alptekin254802/hall-sensor/THIRD_PARTY_NOTICES.md

# Third-party components

The MIT license at the repository root applies to original project code. It
does not replace copyright or license notices in STM32-generated sources,
CMSIS, or the STM32 HAL drivers. Both STM32 source snapshots preserve the
vendor source headers and the supplied license files under their `Drivers/`
directories, including CMSIS and ST device and HAL licenses.

Python, NumPy, pyserial, GNU Arm Embedded tools and Arduino tools are external
dependencies and are not redistributed here. The Creative Commons license
text is reproduced from https://creativecommons.org/licenses/by/4.0/legalcode.txt.
