alptekin254802/hall-sensor/figures/Figure_2_hardware_architecture.pdf

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

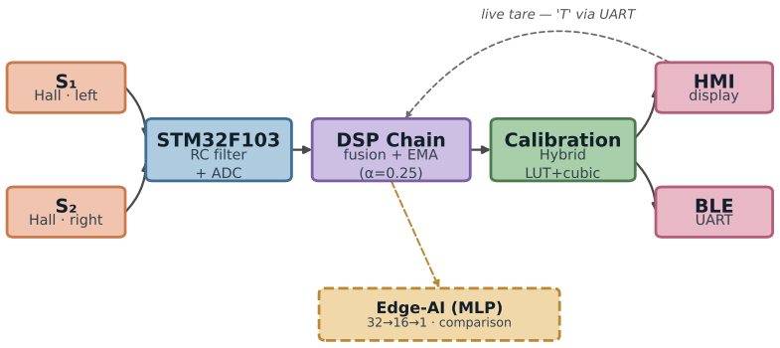
[picture p3: figure]
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
