alptekin254802/hall-sensor/figures/Figure_1a_pcb_final_implementation.jpg

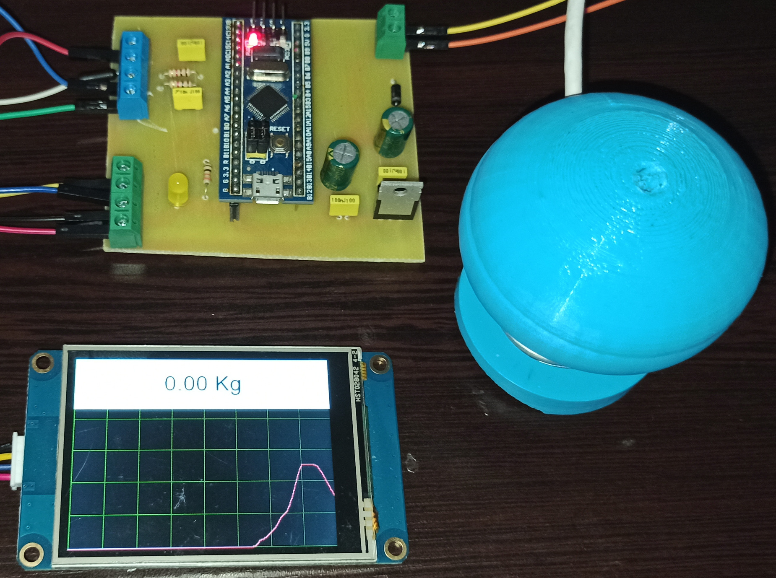
figures/Figure_1a_pcb_final_implementation.jpg
