alptekin254802/hall-sensor/figures/Figure_1b_physical_prototype_views.jpg

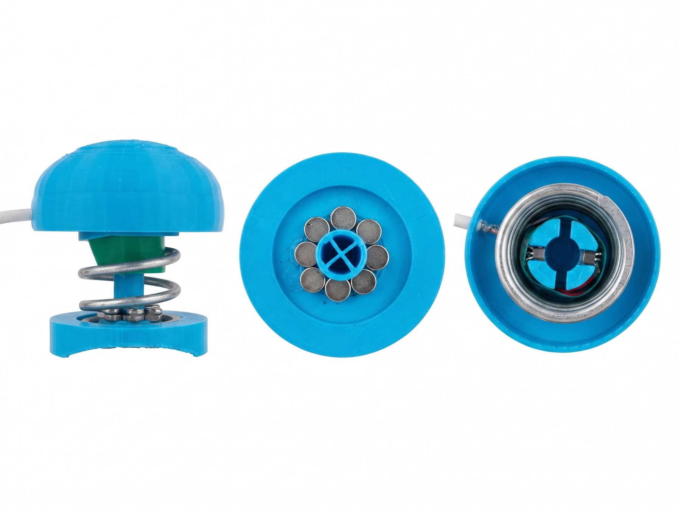
figures/Figure_1b_physical_prototype_views.jpg
