alptekin254802/hall-sensor/data/calibration_plateau_samples.csv

idx | block_grams | block_kg | sample_in_block | S1 | S2 | ORT
0 | 0 | 0.0 | 0 | 2583 | 2671 | 0
1 | 0 | 0.0 | 1 | 2576 | 2671 | 3
2 | 0 | 0.0 | 2 | 2585 | 2670 | 1
3 | 0 | 0.0 | 3 | 2577 | 2669 | 3
4 | 0 | 0.0 | 4 | 2577 | 2670 | 3
5 | 0 | 0.0 | 5 | 2576 | 2671 | 3
6 | 0 | 0.0 | 6 | 2581 | 2670 | 1
7 | 0 | 0.0 | 7 | 2588 | 2672 | 3
8 | 0 | 0.0 | 8 | 2581 | 2668 | 2
9 | 0 | 0.0 | 9 | 2580 | 2662 | 5
10 | 0 | 0.0 | 10 | 2580 | 2666 | 3
11 | 0 | 0.0 | 11 | 2578 | 2671 | 2
12 | 0 | 0.0 | 12 | 2575 | 2670 | 4
13 | 0 | 0.0 | 13 | 2579 | 2672 | 1
14 | 0 | 0.0 | 14 | 2582 | 2670 | 0
15 | 0 | 0.0 | 15 | 2578 | 2669 | 3
16 | 0 | 0.0 | 16 | 2580 | 2668 | 2
17 | 0 | 0.0 | 17 | 2578 | 2671 | 2
18 | 0 | 0.0 | 18 | 2576 | 2667 | 5
19 | 0 | 0.0 | 19 | 2580 | 2670 | 1
20 | 0 | 0.0 | 20 | 2571 | 2667 | 7
21 | 0 | 0.0 | 21 | 2578 | 2672 | 1
22 | 0 | 0.0 | 22 | 2584 | 2667 | 1
23 | 0 | 0.0 | 23 | 2580 | 2669 | 2
24 | 0 | 0.0 | 24 | 2576 | 2669 | 4
25 | 0 | 0.0 | 25 | 2578 | 2672 | 1
26 | 0 | 0.0 | 26 | 2579 | 2670 | 2
27 | 0 | 0.0 | 27 | 2581 | 2671 | 0
28 | 0 | 0.0 | 28 | 2571 | 2672 | 5
29 | 0 | 0.0 | 29 | 2577 | 2674 | 1
30 | 0 | 0.0 | 30 | 2577 | 2670 | 3
31 | 0 | 0.0 | 31 | 2580 | 2669 | 2
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
