alptekin254802/hall-sensor/figures/Figure_11_mlp_training_history.pdf

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

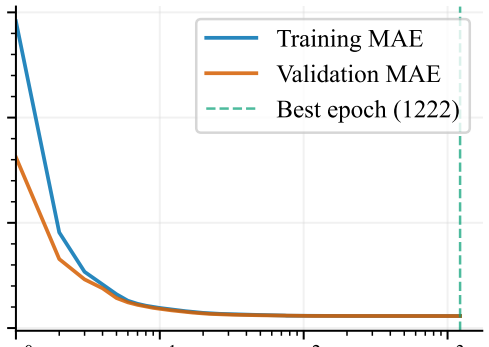
[picture p7: figure]
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
