alptekin254802/hall-sensor/figures/Figure_5_dynamic_response.pdf

## Experimental plateaus

### Dynamic Step Response and Return-to-Zero Stability at Multiple Mass Loads

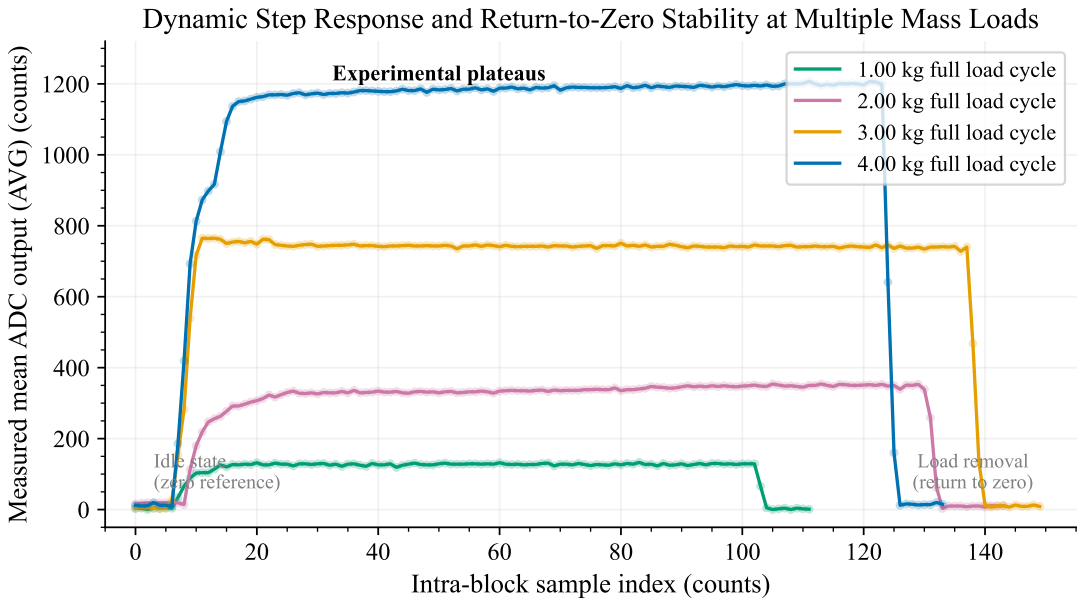
[picture p8: page 1]
Idle state (zero reference)

Measured mean ADC output (AVG) (counts)

1.00 kg full load cycle
2.00 kg full load cycle
3.00 kg full load cycle
4.00 kg full load cycle

Load removal
(return to zero)

Intra-block sample index (counts)
