alptekin254802/hall-sensor/figures/Figure_12_model_comparison_calibration_curve.pdf

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

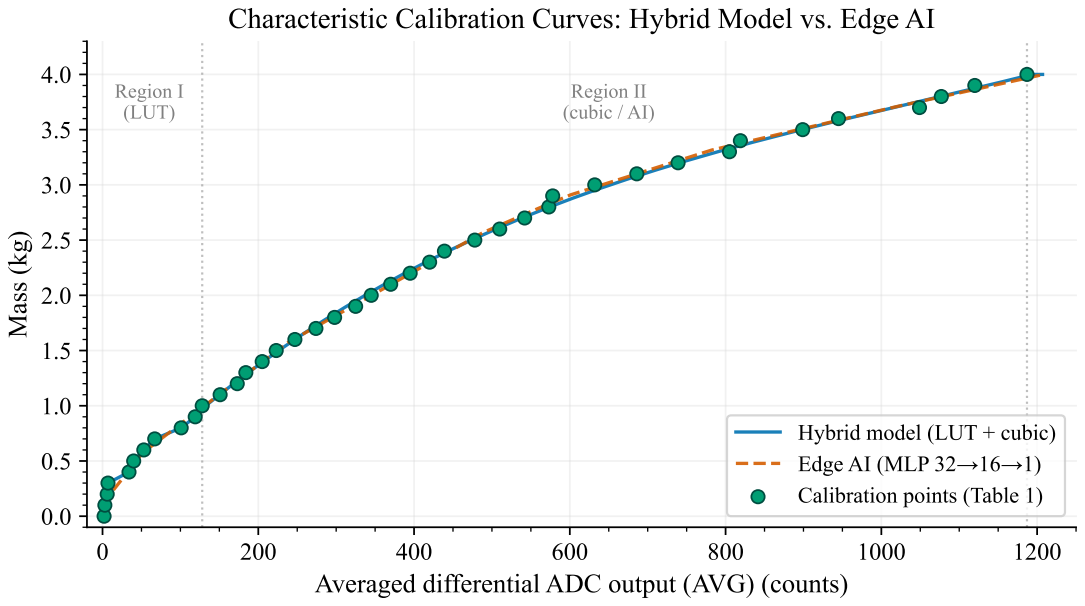
[picture p9: page 1]
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
