alptekin254802/hall-sensor/figures/Figure_6_calibration_residual_error.pdf

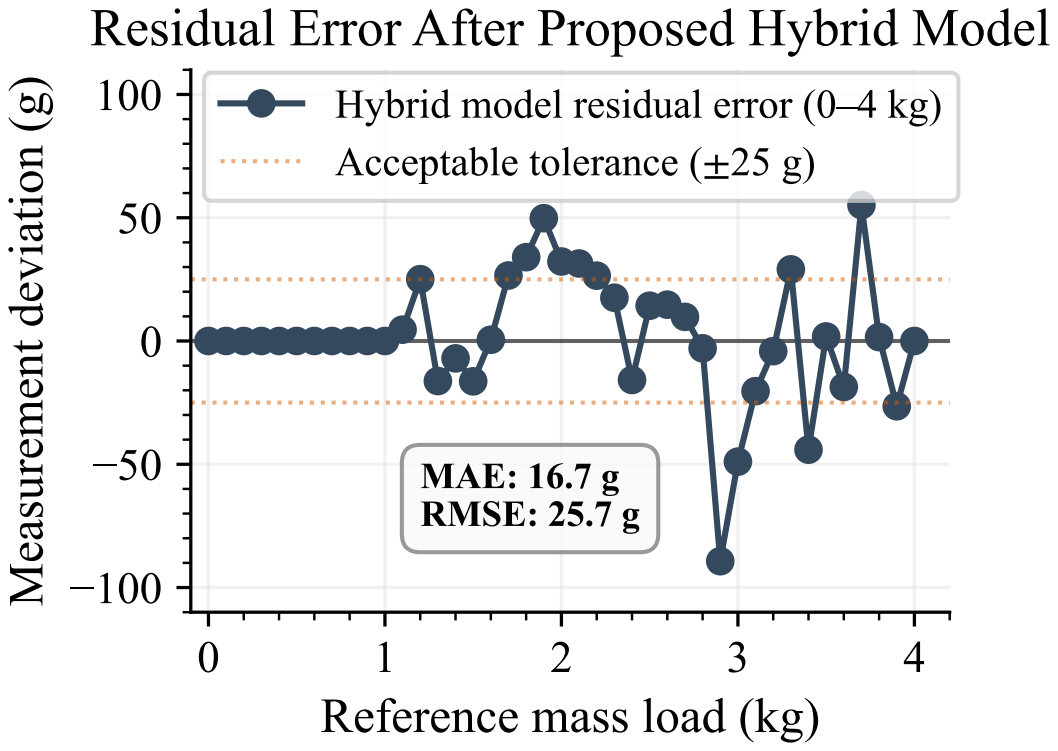
[picture p10: page 1]
