alptekin254802/hall-sensor/figures/Figure_9_live_validation_error.pdf

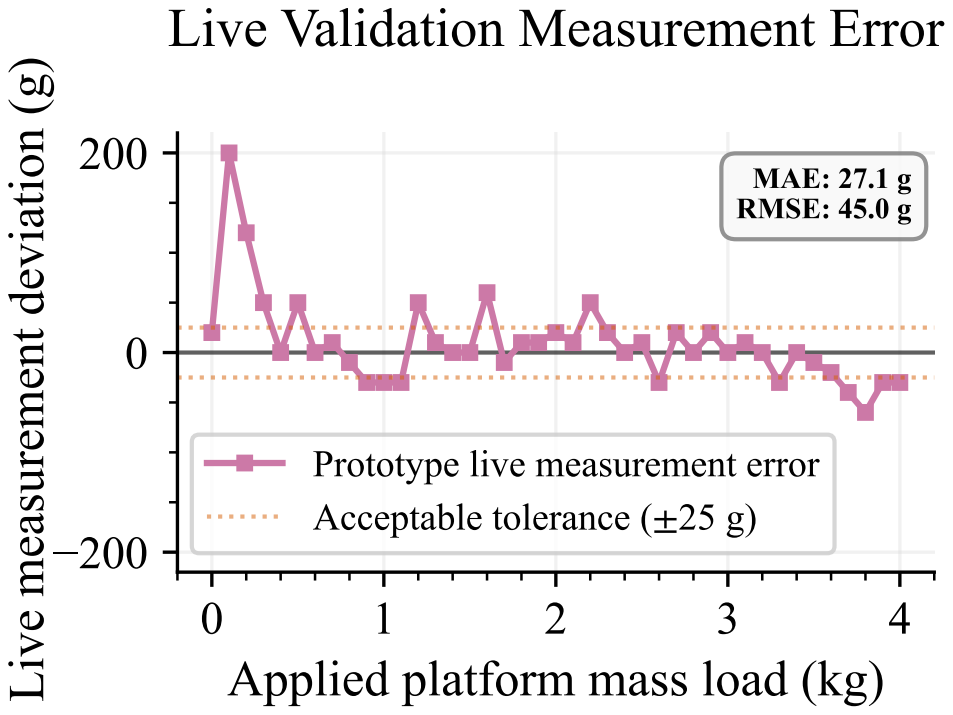
[picture p12: page 1]
