alptekin254802/hall-sensor/figures/Figure_10_hysteresis_analysis.pdf

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

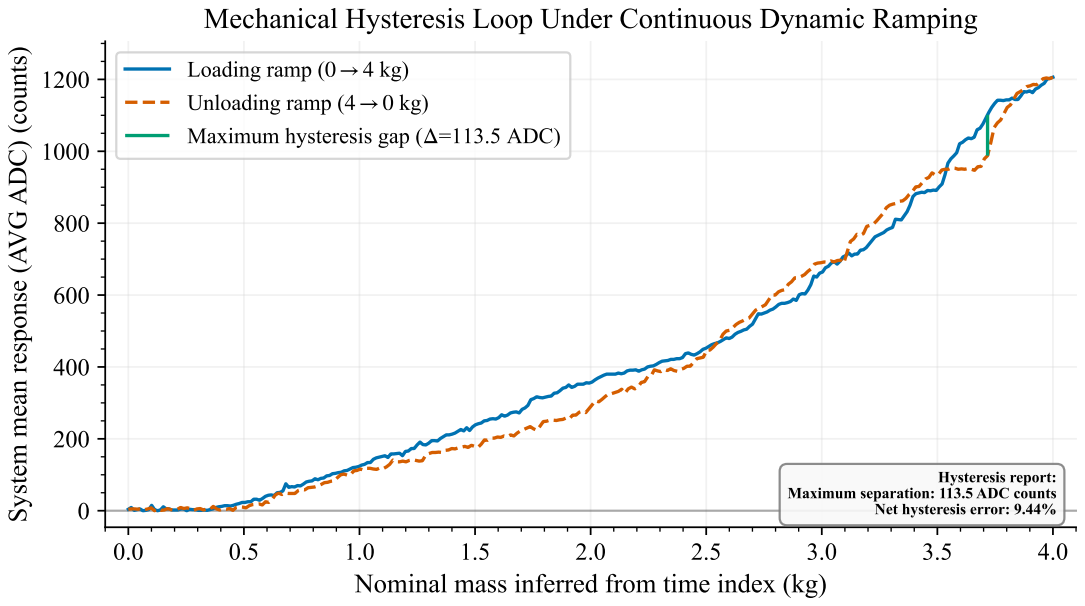
[picture p13: page 1]
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
