alptekin254802/hall-sensor/figures/Figure_3_ema_filter_response.pdf

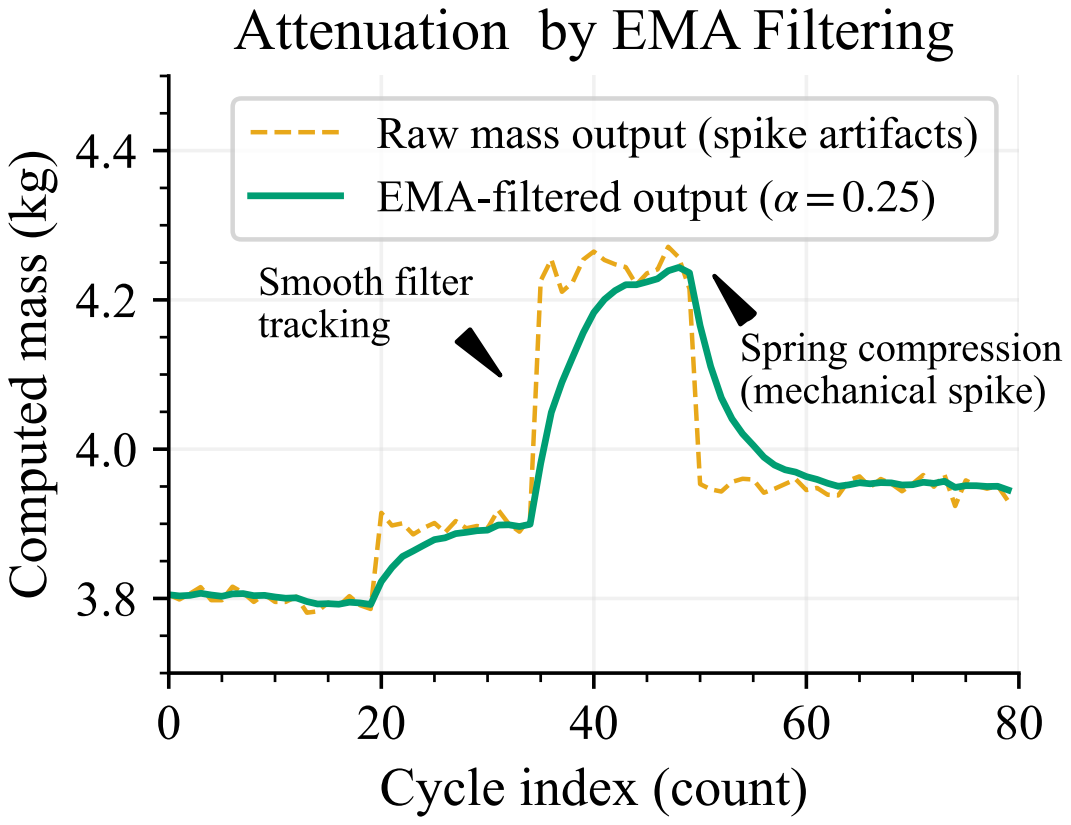
[picture p14: page 1]
