alptekin254802/hall-sensor/figures/Figure_4_stick_slip_correction.pdf

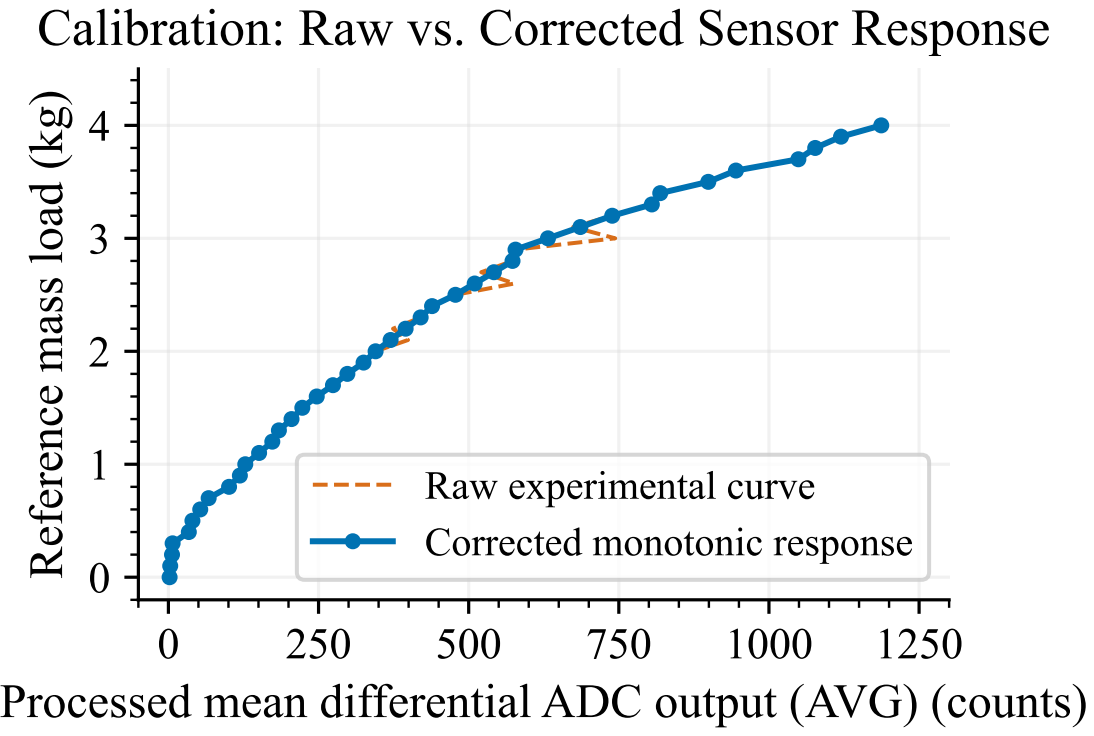
[picture p15: page 1]
