alptekin254802/hall-sensor/figures/Figure_8_spatial_fusion_asymmetry.pdf

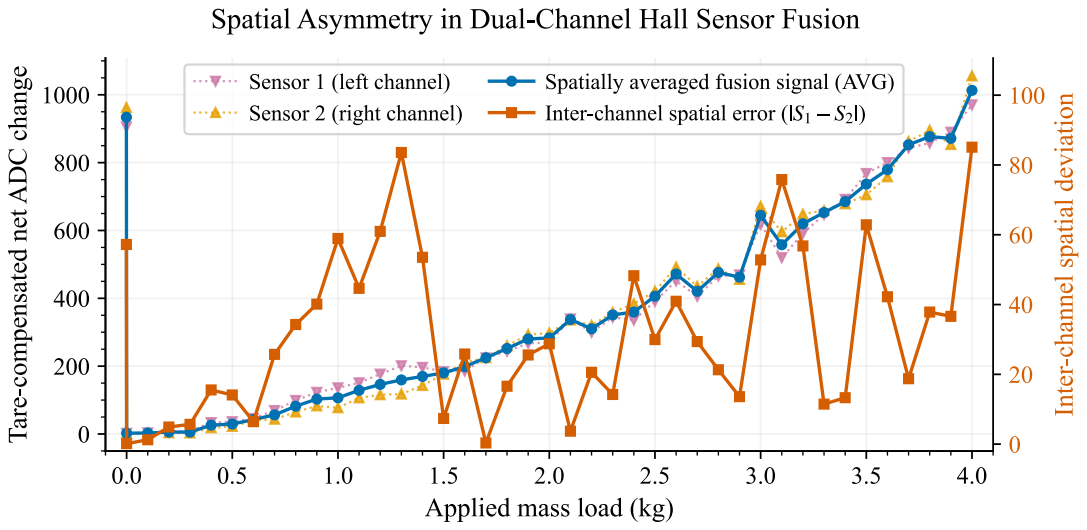
[picture p16: page 1]
