alptekin254802/hall-sensor/firmware/stmfinal.ioc

Mcu.UserName=STM32F103C8Tx
PA0-WKUP.Signal=ADCx_IN0
PA1.Signal=ADCx_IN1
PA10.Signal=USART1_RX
PA2.Signal=USART2_TX
PA3.Signal=USART2_RX
PA4.GPIO_Label=KUTLE_LED
PA4.Signal=GPIO_Output
PA9.Signal=USART1_TX
PD0-OSC_IN.Signal=RCC_OSC_IN
PD1-OSC_OUT.Signal=RCC_OSC_OUT
