alptekin254802/hall-sensor/firmware/Core/Inc/nn_model.h

/* ===================================================================== */
/* STM32F103 Edge-AI MLP inference baseline                             */
/* Architecture: 1 -> 32 (LeakyReLU 0.1) -> 16 (LeakyReLU 0.1) -> 1     */
/* Calibration-reference MAE/RMSE: 27.37 g / 38.65 g                    */
/* Plateau diagnostic MAE/RMSE: 67.03 g / 126.72 g                      */
/* ===================================================================== */

#ifndef NN_MODEL_H
#define NN_MODEL_H

#include <stdint.h>

#define NN_MIN_ADC 0.0f
#define NN_MAX_ADC 1207.0f

static const float NN_W1[32] = {
    -0.371371f, -0.368313f, -0.128166f, 0.397745f, 0.436248f, 0.307741f, 0.441027f, -0.117582f,
    -0.886303f, 0.099410f, 0.450700f, 0.018595f, 0.338316f, -0.200150f, 0.081709f, -0.267788f,
    0.478124f, 0.163858f, -0.474304f, -0.100582f, 0.311474f, 0.318172f, -0.078074f, 0.168866f,
    -0.344390f, 0.312104f, 0.434629f, 0.199223f, -0.290804f, -0.254351f, 0.265398f, 0.244546f
};
static const float NN_B1[32] = {-0.115315f, -0.098745f, -0.092693f, 0.121648f, 0.098705f, 0.110653f, 0.091695f, 0.198294f, 0.423590f, 0.095808f, 0.000002f, -0.037202f, 0.089031f, -0.078038f, 0.119986f, -0.121070f, 0.123259f, 0.101698f, -0.095394f, 0.175040f, -0.229479f, 0.105061f, 0.193727f, 0.082371f, -0.091344f, 0.113868f, 0.107692f, 0.086722f, -0.094611f, -0.108912f, 0.100744f, 0.044260f};

static const float NN_W2[512] = {
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

static const float NN_W3[16] = {
    -0.196244f, -1.099516f, 0.372641f, -0.479150f, 0.370653f, -0.534766f, -0.271683f, 0.601933f,
    -0.384379f, -0.350361f, 0.660154f, 0.589207f, -0.578365f, -0.902134f, -0.657096f, 0.564748f
};
static const float NN_B3[1] = {0.087995f};


/**
 * @brief  YSA ile agirlik tahmini (Edge AI)
 * @param  ham_adc: Fuzyon sonrasi ORT ADC degeri (0-1207 arasi)
 * @retval Tahmin edilen kutle (kg, 0.0-4.0 arasi)
 */
float AI_Agirlik_Tahmin(uint32_t ham_adc) {
    /* Giris normalizasyonu: [0, MAX_ADC] -> [0, 1] */
    float input = ((float)ham_adc - NN_MIN_ADC) / (NN_MAX_ADC - NN_MIN_ADC);
    if (input < 0.0f) input = 0.0f;
    if (input > 1.0f) input = 1.0f;

    /* Katman 1: Dense(1 -> 32) + LeakyReLU(alpha=0.1) */
    float L1[32];
    for (int i = 0; i < 32; i++) {
        float val = input * NN_W1[i] + NN_B1[i];
        L1[i] = (val > 0.0f) ? val : val * 0.1f;
    }

    /* Katman 2: Dense(32 -> 16) + LeakyReLU(alpha=0.1) */
    float L2[16];
    for (int i = 0; i < 16; i++) {
        float sum = 0.0f;
        for (int j = 0; j < 32; j++) {
            sum += L1[j] * NN_W2[j * 16 + i];
        }
        float val = sum + NN_B2[i];
        L2[i] = (val > 0.0f) ? val : val * 0.1f;
    }

    /* Cikis Katmani: Dense(16 -> 1) */
    float kg = 0.0f;
    for (int i = 0; i < 16; i++) {
        kg += L2[i] * NN_W3[i];
    }
    kg += NN_B3[0];

    /* Guvenlik sinirlari */
    if (kg < 0.0f) kg = 0.0f;
    if (kg > 4.0f) kg = 4.0f;
    return kg;
}

#endif /* NN_MODEL_H */
