alptekin254802/hall-sensor/firmware/stm32/v0_5_0/Core/Inc/display_knots.h

/* Frozen A interpolation. Generated from display_model.json. */
#define DISPLAY_MODEL_ID "497c5c8fbd85a4ef4284da84ff57cb27144c7f28b633eb0435fdb7966894c42d"
static const double x_knots[] = {0.0, 5.693622622622513, 9.579383383383345, 31.320582332332265, 53.32597434934934, 81.35015415415415, 126.23937825325322, 140.9345887137137, 194.79235773273263, 297.00635773273274, 539.2365365365365, 803.701501126126, 1270.6296296296296};
static const double mass_knots[] = {0.0, 50.0, 100.0, 300.99999999999994, 499.99999999999994, 702.0, 999.9999999999999, 1203.0, 1502.0, 2003.0, 3004.9999999999995, 4006.9999999999995, 4999.999999999999};
